ednieuw/Woordklok-witte-LEDs/WhiteLED_Word_clock_V1.0.0/functionlistV001.txt

//------------------------------------------------------------------------------
// CLOCK V1.0.0
//------------------------------------------------------------------------------                           

void loop()
void setup()
void SWversion(void) 
void PrintLine(byte Lengte)
void Reset(void)
void EverySecondCheck(void)
void EveryMinuteUpdate(void)
void EveryHourUpdate(void)
void EveryDayUpdate(void)
void Demomode(void)
void Tekstprint(char const *tekst)
void Tekstprintln(char const *tekst)
void InputDevicesCheck(void)
void SerialCheck(void)
void RotaryEncoderCheck(void)
void Selftest(void)
void Displaytime(void)
void GetTijd(byte printit)
void Print_RTC_tijd(void)
void Print_tijd(void)
void SetRTCTime(void)
int get3231Temp(void)
void ShiftInTime(const char TimeText[10], byte num , byte Displaynr, byte Shiftbit, byte ShiftIn)
void LedsOff(void)
void WriteLEDs(void) 
void Laatzien()
void DimLeds(byte print) 
void Play_Lights()
void BlinkUUR(int NoofBlinks, int Delayms)
void BlinkHETISWAS (int NoofBlinks, int Delayms)
void WriteLightReducer(int amount)
void WriteLowerBrightness(byte waarde)
int SConstrainInt(String s,byte first,byte last,int low,int up)
int SConstrainInt(String s,byte first,          int low,int up)
void ReworkInputString(String InputString)
