ednieuw/Woordklok-witte-LEDs/Bouwpakket_files/FM1.jpg

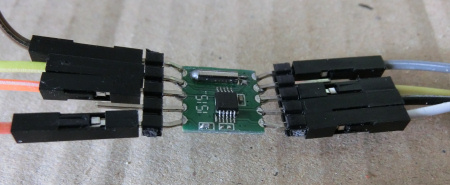
Bouwpakket_files/FM1.jpg
