ednieuw/Woordklok-witte-LEDs/Bouwpakket_files/FM2.jpg

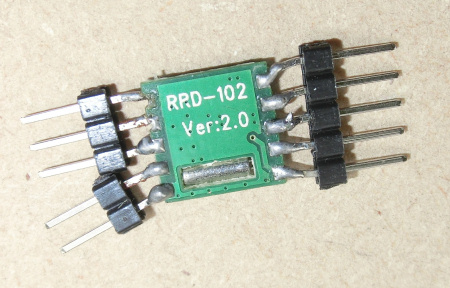
Bouwpakket_files/FM2.jpg
