ednieuw/Woordklok-witte-LEDs/Bouwpakket_files/FM-Radio layout.jpg

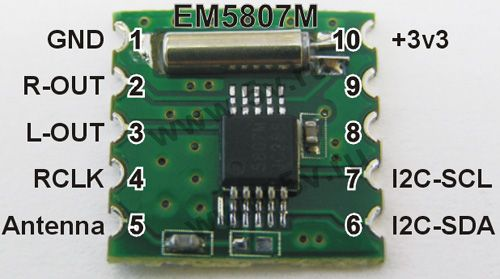
Bouwpakket_files/FM-Radio layout.jpg
