ednieuw/Woordklok-witte-LEDs/Bouwpakket_files/FTDI2.jpg

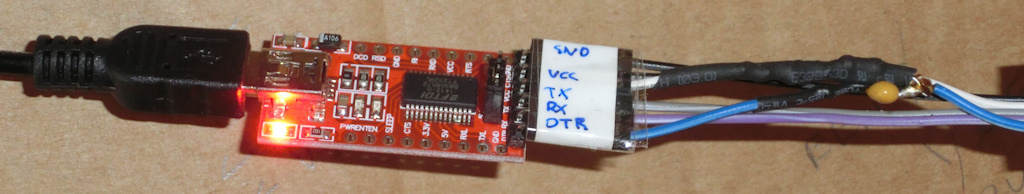
Bouwpakket_files/FTDI2.jpg
