ednieuw/Woordklok-witte-LEDs/Bouwpakket_files/HC-05.jpg

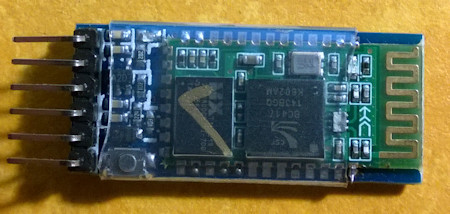
Bouwpakket_files/HC-05.jpg
