ednieuw/Woordklok-witte-LEDs/Bouwpakket_files/HM-10 HC05.jpg

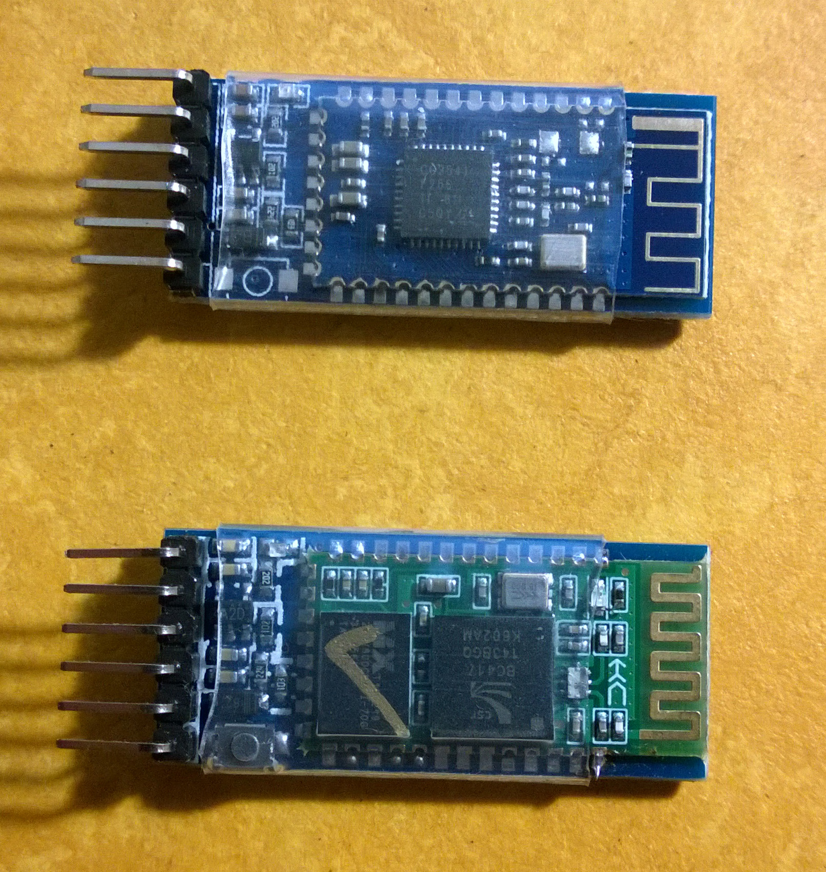
Bouwpakket_files/HM-10 HC05.jpg
