ednieuw/Woordklok-witte-LEDs/Bouwpakket_files/HM-10.jpg

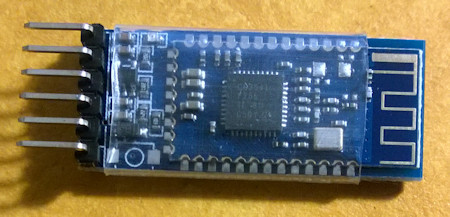
Bouwpakket_files/HM-10.jpg
