ednieuw/Woordklok-witte-LEDs/Bouwpakket_files/image001.jpg

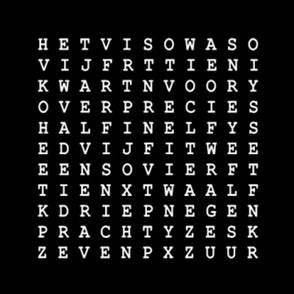
Bouwpakket_files/image001.jpg
