ednieuw/Woordklok-witte-LEDs/Bouwpakket_files/image050.jpg

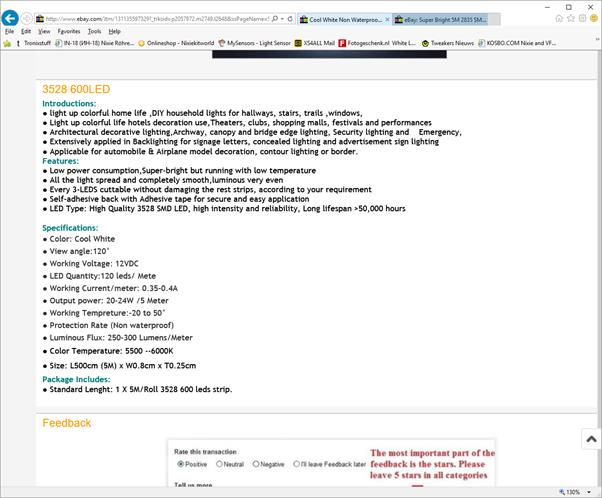
Bouwpakket_files/image050.jpg
