ednieuw/Woordklok-witte-LEDs/Bouwpakket_files/ttl-level533.jpg

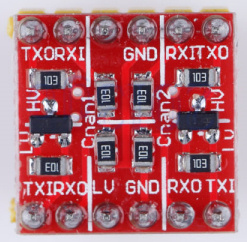
Bouwpakket_files/ttl-level533.jpg
