ednieuw/Woordklok-witte-LEDs/Bouwpakket_files/Verlichtingsplaat-CIMG3008.JPG

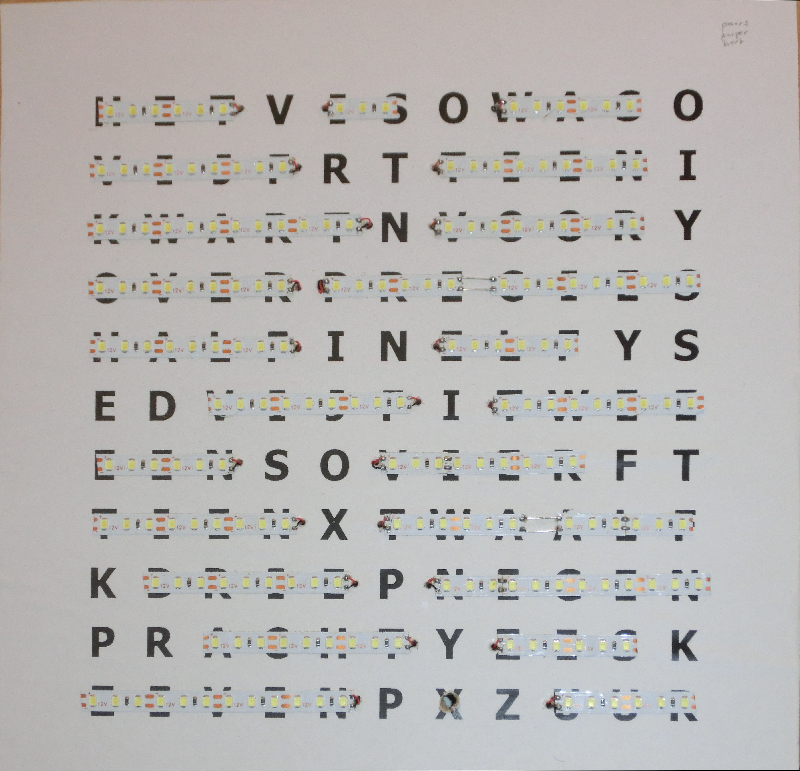
Bouwpakket_files/Verlichtingsplaat-CIMG3008.JPG
