ednieuw/Woordklok-witte-LEDs/(commit log)

2020-03-10 V108 Voorkomt tijd verspringen door stroomdips van de voeding
    Pulsen op het lichtnet kunnen valse signalen doorgeven die door het rotary draaiknopalgoritme verwerkt worden als het draaien aan de draaiknop, bij deze versie V108 kan de tijd 60 seconden lang verzet worden nadat de draaiknop is gedrukt.
2020-03-10 V090 Stabiele versie
    The following Arduino code controls both the ATMEGA328 and ATMEGA1284 chip on the PCB board
    capable of switching on/off 32 LED strips or relais
    Attached to this PCB are:
    - RCT DS3231 ZS-042 clock module
    - KY-040 Keyes Rotary Encoder
    - LDR light sensor 5528
    - Bluetooth RF Transceiver Module HC05
    - DCF77 module DCF-2
    - FM Stereo Radio Module RDA5807M RRD-102V2.0
    - I2C TWI 1602 16x2 Serial LCD Display
    - Red_MAX7219_8-Digit_LED_Display
    - temperature sensor Dallas DS1820
2020-03-10 Basisversie van de woordklok
    De eerst stabiele versie voor de woordklok
2020-03-10 Foto van een woordklok
2021-04-16 New features. KEYPADs Bugfixes
    Changes.: V109 Added features of Character_Colour_Clock_V067 like KEYPADs Menu structure, EEPROM struct
    Solved all compiler warning. UseDCF turns off LED on board when turned Off. Use DCF added to menu
    Changed constrain(mem,0,250) -->= min(mem,250)
2021-05-24 V112 + libraries in zip
    Changes.: V107 Rotary bug, "noise on AC line", solved by changing rotary press/rotate options
    Changes.: V108 Changed time settings in rotary for Kees Soeters. Time text in ShiftInTime function instead from array
    Changes.: V110 Added OneWire keypad 3x1 and 3x4
    Changes : V111 Bugfixes
    Changes : V112 Clear NVRAM in menu option C. Store more menu text in PROGMEM
    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
2021-05-24 Web pagina
    Beschrijving hoe de klok te bouwen
2021-11-26 V113
    Added LDR reading printed every second in Serial monitor
2021-11-26 V113 libraries in ZIP
    Added LDR readings every second printed in serial monitor
2022-03-23 Basisversie met draaiknop en klokmodule
    Gestripte basisversie uitgegaan van versie V112 waaruit alle overbodige functionaliteit is verwijderd.
    De klok heeft een draaiknop en de tijd wordt met een DS3231of vergelijkbare I2C module bijgehouden
    Met V112 en hoger kan functionaliteit aan en uit worden gezet dmv #defines.
2022-04-04 V114
    Changes : V113 Added option W in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
    [Character_Clock_V114.ino]
2024-07-31 V126 Ulrich's klok
    Changes V120: To turn On/Off LEDs removed from DimLeds if(LEDsAreOff) BrightnessCalcFromLDR = 0;
    and added in Displaytime() if(LEDsAreOff) { LedsOff(); }
    Changes V121: Removed FM-radio <--> DEAD END
    Changes V122: From V117a
    Removed FMRADIOMOD DS1820 LCDMOD MAX7219_8DIGIT ATMEAGA 1284 support
    Changes V123: Opgeruimd en Ulrich's klok toegevoegd
    Changes V124; Removed Selftest from Loop and added to one run Menu option S
    Changes V125: Bij NLUV klok: if (Iminute > 18 ) sayhour = Ihour+1; if (Iminute > 19 ) sayhour = Ihour+1;
    Changes V126: Twee fouten gevonden. Uitvallen van het UUR een minuut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
